fujiba/2FA_Sidecar/(commit log)

2025-08-14 mini版での動作可能バージョン
2025-08-14 ひとまず動作
2025-08-14 ちらつき抑制
2025-08-14 なんとか期待通り？に動いてるっぽい
2025-08-14 ログ抑制
2025-08-15 AsyncWebServer→WebServer
2025-08-15 コメントを英語に
2025-08-15 README更新
2025-08-17 fix(boot): Resolve device hang when serial monitor is not connected
    The previous implementation used a `while (!Serial)` loop that would wait indefinitely for a serial connection. This caused the device to hang at boot if a serial monitor was not present, making it unresponsive.
    This commit introduces a 3-second timeout to this connection check. If a connection is not established within this period, the boot process will continue, ensuring the device remains fully operational.
    [2FA_Sidecar.ino, debug_log.h]
